saumyahindocha/self-balancing-bot/docs/images/itsp-2026-poster.jpg

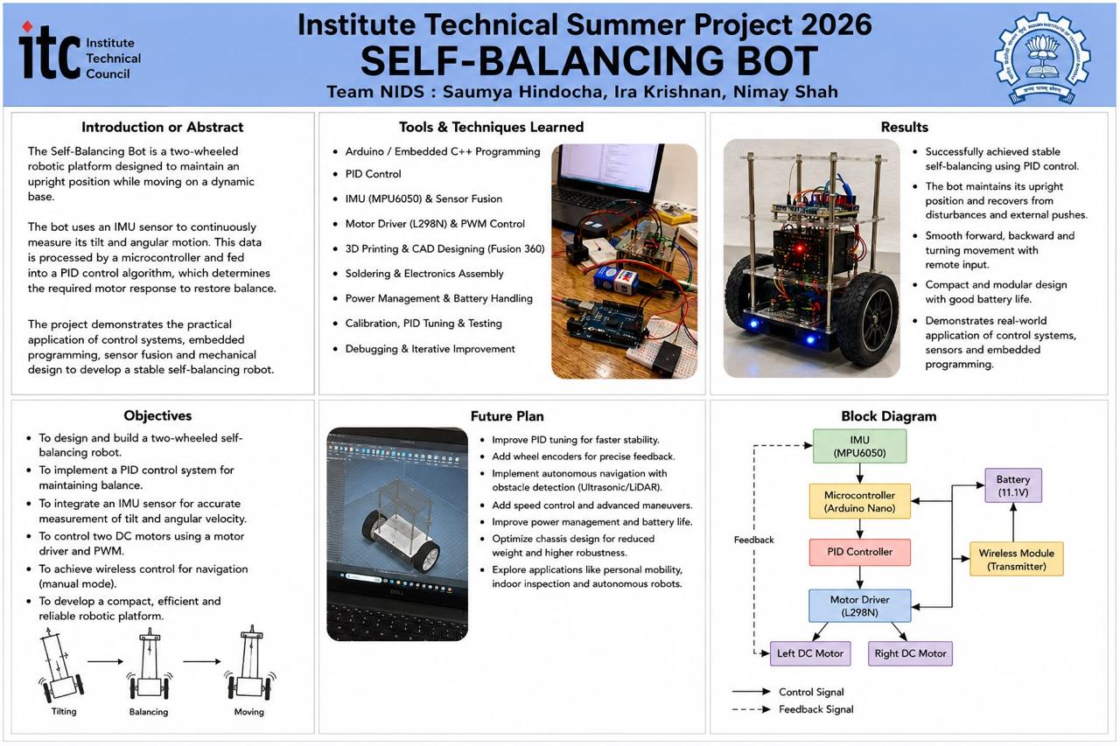
docs/images/itsp-2026-poster.jpg
