saumyahindocha/self-balancing-bot/hardware/remote-pcb/gerbers/How-to-order-PCB.txt

How to Order PCB

Please refer to:
https://prodocs.easyeda.com/en/pcb/order-order-pcb/index.html
