saumyahindocha/self-balancing-bot/(commit log)

2026-10-08 Self-balancing robot: firmware, hardware files, MATLAB model and docs
    Consolidated from the project chat history (May-Aug 2026):
    - firmware/balance: current balance-only controller (FastIMU + Kalman + PID)
    - firmware/tests: bench sketches for IMU, IR, L298N, dead zone, direction, NRF
    - firmware/archive: NRF remote + IR line-following versions (shelved)
    - hardware: BOM, laser-cut chassis SVGs, remote PCB notes
    - matlab: reconstructed linearised model and PID check
    - docs: progress log, wiring, tuning, simulation
    Fixes found during consolidation: FastIMU calibrateAccelGyro() was passed an
    int instead of a calData pointer, and the archived receiver drove the left
    and right motors with each oth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
    [bom.csv]
2026-10-08 Add build photos, balancing video, remote PCB Gerbers
    - docs/images: CAD screenshots, bench setup, assembled robot (18 Aug),
    remote enclosure, ITSP 2026 exhibit and poster, PCB layer render,
    balancing GIF for the README
    - docs/media: unassisted balancing run and handheld motor test (audio removed)
    - hardware/remote-pcb/gerbers: EasyEDA Pro fabrication output, 26 May 2026
    - README, progress log and PCB notes updated: the robot balances unassisted
    Claude-Session: https://claude.ai/code/session_01CCUchVju4G2UvyFTggRsD4
    [Drill_NPTH_Through.DRL, Drill_PTH_Through.DRL, Drill_PTH_Through_Via.DRL, Gerber_BoardOutlineLayer.GKO, Gerber_BottomLayer.GBL, Gerber_BottomSilkscreenLayer.GBO, Gerber_BottomSolderMaskLayer.GBS, Gerber_TopLayer.GTL]
